Board-Outline/Macro_Keyboard_V1.0/Macro_Keyboard_Main_Board_V1.0/Battery Notes.txt

Considered chargers - BQ25170, BQ24075RGT

https://tinycircuits.com/collections/batteries

https://tpetrov.com/baterii/akumulatorni-baterii/li-po-baterii

https://vikiwat.com/akumulatorni-baterii.html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

https://www.olx.bg/d/ad/bateriya-3-7-v-180-mah-270-mah-7-4-v-2000mah-li-po-li-ion-battery-volta-CID632-ID7R0fO.html
