Board-Outline/Macro_Keyboard_V1.0/(threads)

Thread 1 (2023-06-14):

Questions regarding setup

WainingForests, 2023-06-14:
The MDBT50Q-1MV2; how does one go about programming flashing? Is it simple SMD solder all the required components and then flash it with ZMK firmware? Or do I need to figure out how to flash it with nordic SDK / use the hex from the Mikoto repo?

Any clarity on this would be greatly appreciated!

Board-Outline, 2023-06-28:
Hi.

I apologize for the lack of instructions in this project. I believed this repo was set to private. I was going to open source it after I completed it.

First you need to install a nRF52 bootloader from [here](https://github.com/adafruit/Adafruit_nRF52_Bootloader). Then you can install ZMK as normal. Keep in mind that I still don't have a correct configuration written, I took a long hiatus from this project), so you will have to write your own.

**Important note:** There are hardware problems with this board. the D+ and D- on the USB are flipped. There were also other problems with this board. Its a first prototype after all. I have notes written on my schematics at my home PC and I will commit them when I get back in a day or two. Read them carefully before you order this board.

Board-Outline, 2023-06-28:
The module works well with ZMK and I had some configuration written for it. By memory I don't think I had huge software problems. The only problem I had was with soldering, since its an LGA. It took me a 2-3 tries with a hot plate to solder it properly.
In case you are going to reuse the battery schematic, keep in mind that I've only done very limited testing with the battery. No long term safety testing at all.

I've attached a photo of the board with all the problems I've found:
- Flipped USB Lines
- Wrong power on the SWD connector (the cut and the wire are for that)
- Wrong footprint on Q1 (Source and drain are switched)
- Wrong footprint on TH1

I've really screwed the pooch on such a simple board, but the MCU boots and it works.

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

WainingForests, 2023-06-28:
I'm taking the new mikoto battery circuitry and using it based on your work. My biggest concern was me not understanding how bootloaders were programed but with the pico probe I've managed to at least get the mikoto bootloader working. Next up is figuring how to modify the bootloader settings which is very much out of my wheel house.

I swear getting a prototype without 3 bodge wires for me is like hitting the lottery!

Board-Outline, 2023-06-28:
I've never used the Pico Probe, It looks to be a nice bit of kit. A personal favorite debugger/programmer is the Segger J-Link EDU. Its slightly more expensive but the Segger software is so good compared to OpenOCD. The important thing is that you've done that job and you made it work. :)

At work I tend to design more complex projects (300-500 components on a board) and usually I have lower error rate on first prototypes. It was my second time using KiCAD and most of my attention was focused on using it correctly. Still its bodgable, and it works fine.

Best of luck on your project, if you need any help, feel free to ask.
