Board-Outline/Macro_Keyboard_V1.0/Macro_Keyboard_Main_Board_V1.0/Macro_Keyboard_Main_Board_V1.0.kicad_pcb

## KiCad design Macro_Keyboard_Main_Board_V1.0/Macro_Keyboard_Main_Board_V1.0.kicad_pcb (2022-11-27)

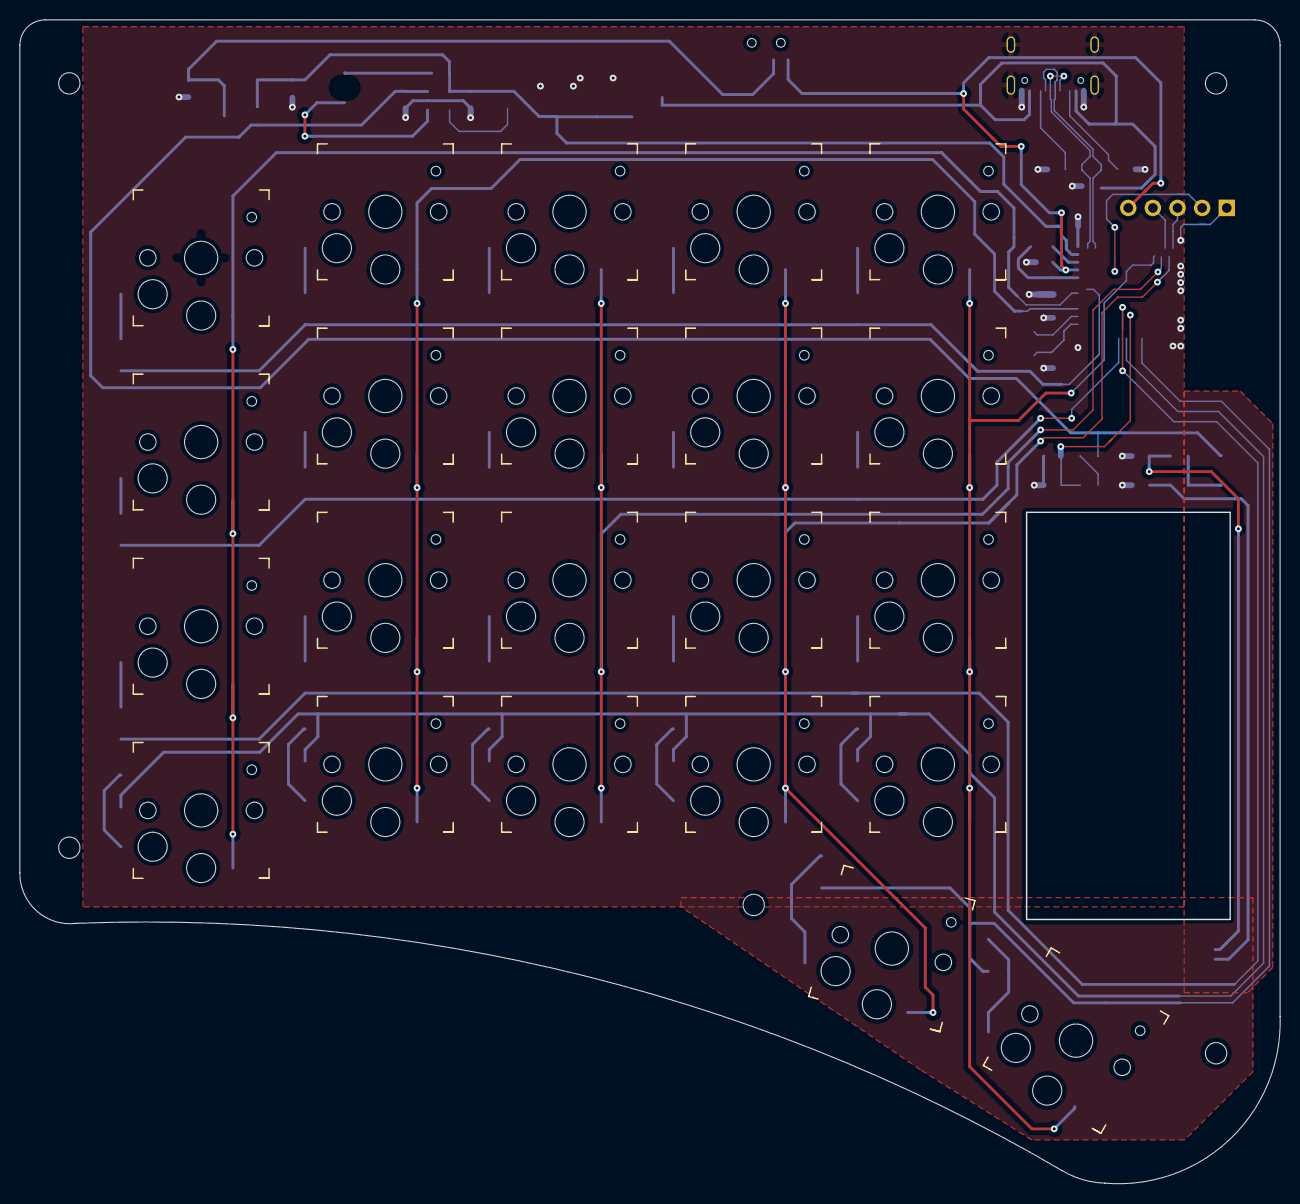
[picture p20: board Macro_Keyboard_Main_Board_V1.0.kicad_pcb from above]

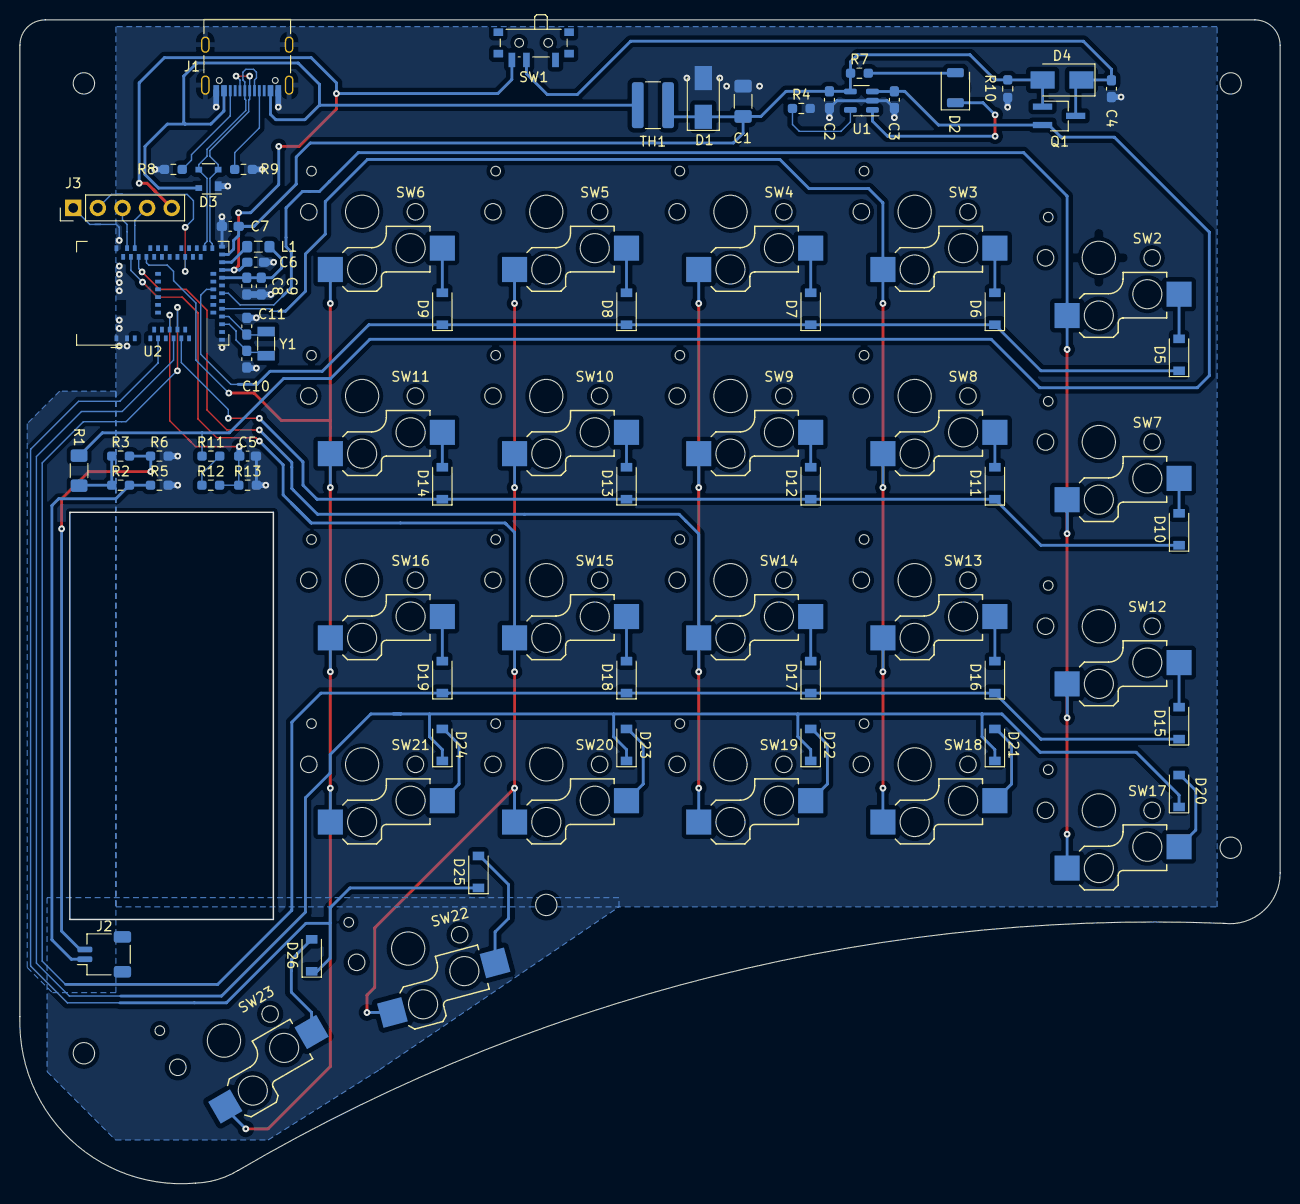
[picture p21: board Macro_Keyboard_Main_Board_V1.0.kicad_pcb from below]

Board: 2 copper layers, 130.0 x 120.1 mm, 87 parts (60 on the bottom side), 57 nets.

Parts:
C1: 10uF; C_1206_3216Metric_Pad1.33x1.80mm_HandSolder
C2, C3, C4, C6, C7, C9: 4u7F; C_0603_1608Metric_Pad1.08x0.95mm_HandSolder
C5: 10nF; C_0603_1608Metric_Pad1.08x0.95mm_HandSolder
C8: 1uF; C_0603_1608Metric_Pad1.08x0.95mm_HandSolder
C10, C11: 15pF; C_0603_1608Metric_Pad1.08x0.95mm_HandSolder
D1: SMAJ5.0A; D_SMA
D2: LED; LED_1206_3216Metric_ReverseMount_Hole1.8x2.4mm
D3: PRTR5V0U2X; SOT-143
D4: B160-E3; D_SMA
D5, D6, D7, D8, D9, D10, D11, D12, D13, D14, D15, D16, D17, D18, D19, D20, D21, D22, D23, D24, D25, D26: 1N4148W; D_SOD-123
H1, H2, H3, H4, H5: MountingHole M2; MountingHole_2.2mm_M2_ISO14580
J1: USB_C_Receptacle_USB2.0; USB_C_Receptacle_Palconn_UTC16-G
J2: JST SM02B-SRSS-TB(LF)(SN); JST_SH_SM02B-SRSS-TB_1x02-1MP_P1.00mm_Horizontal
J3: Conn_01x05; PinHeader_1x05_P2.54mm_Vertical
L1: 10uH; L_0805_2012Metric_Pad1.05x1.20mm_HandSolder
Q1: DMG2301L-7; TSOT-23_HandSoldering
R1: 0R; R_1206_3216Metric_Pad1.30x1.75mm_HandSolder
R2, R6, R7: N.F.; R_0603_1608Metric_Pad0.98x0.95mm_HandSolder
R3, R5: 0R; R_0603_1608Metric_Pad0.98x0.95mm_HandSolder
R4: 20K; R_0603_1608Metric_Pad0.98x0.95mm_HandSolder
R8, R9: 5K1; R_0603_1608Metric_Pad0.98x0.95mm_HandSolder
R10: 10K; R_0603_1608Metric_Pad0.98x0.95mm_HandSolder
R11, R12: 2M; R_0603_1608Metric_Pad0.98x0.95mm_HandSolder
R13: 10M; R_0603_1608Metric_Pad0.98x0.95mm_HandSolder
SW1: SW_SPDT PCM12SMTR; SW_SPDT_PCM12
SW2, SW3, SW4, SW5, SW6, SW7, SW8, SW9, SW10, SW11, SW12, SW13, SW14, SW15, SW16, SW17, SW18, SW19, SW20, SW21, SW22, SW23: SW_Push; Kailh_socket_PG1350
TH1: MF-MSMF050-2; R_1218_3246Metric_Pad1.22x4.75mm_HandSolder
U1: MCP73831T-2ACI/OT; SOT-23-5
U2: MDBT50Q-1MV2; Raytac_MDBT50Q
Y1: 32768Hz; Crystal_SMD_3215-2Pin_3.2x1.5mm

Connections:
+BATT: C3.1, Q1.2 (D), R1.1, R11.1, U1.3 (VBAT)
/keyboard/BAT_VOUT: C5.1, R12.2, R13.1, U2.9 (P0.03/AIN1)
/keyboard/CC1: J1.A5 (CC1), R9.1
/keyboard/CC2: J1.B5 (CC2), R8.1
/keyboard/COL1: SW2.1, SW7.1, SW12.1, SW17.1, U2.24 (P0.08)
/keyboard/COL2: SW3.1, SW8.1, SW13.1, SW18.1, U2.20 (P0.04/AIN2)
/keyboard/COL3: SW4.1, SW9.1, SW14.1, SW19.1, U2.50 (P1.02)
/keyboard/COL4: SW5.1, SW10.1, SW15.1, SW20.1, SW22.1, U2.52 (P0.09/NFC1)
/keyboard/COL5: SW6.1, SW11.1, SW16.1, SW21.1, SW23.1, U2.49 (P0.25)
/keyboard/RESET: J3.2, U2.40 (~RESET/P0.18)
/keyboard/ROW1: D5.1 (K), D6.1 (K), D7.1 (K), D8.1 (K), D9.1 (K), U2.25 (P1.08)
/keyboard/ROW2: D10.1 (K), D11.1 (K), D12.1 (K), D13.1 (K), D14.1 (K), U2.12 (P0.31/AIN7)
/keyboard/ROW3: D15.1 (K), D16.1 (K), D17.1 (K), D18.1 (K), D19.1 (K), U2.11 (P0.02/AIN0)
/keyboard/ROW4: D20.1 (K), D21.1 (K), D22.1 (K), D23.1 (K), D24.1 (K), U2.10 (P0.29/AIN5)
/keyboard/ROW5: D25.1 (K), D26.1 (K), U2.6 (P1.13)
/keyboard/SWDCLK: J3.3, U2.53 (SWDCLK)
/keyboard/SWDIO: J3.4, U2.51 (SWDIO)
/keyboard/USB_N: D3.3 (I/O2), J1.A7 (D-), J1.B7 (D-), U2.35 (D+)
/keyboard/USB_P: D3.2 (I/O1), J1.A6 (D+), J1.B6 (D+), U2.34 (D-)
GND: C1.2, C2.2, C3.2, C4.2, C5.2, C6.2, C7.2, C8.2, C9.2, C10.1, C11.1, D1.2 (A), D3.1 (GND), J1.A1 (GND), J1.A12 (GND), J1.B1 (GND), J1.B12 (GND), J1.S1 (SHIELD), J3.1, R4.2, R5.2, R6.2, R8.2, R9.2, R10.2, R13.2, U1.2 (VSS), U2.1 (GND), U2.2 (GND), U2.15 (GND), U2.33 (GND), U2.55 (GND)
unnamed: C4.1, D4.1 (K), Q1.3 (S), SW1.2 (B)
unnamed: C8.1, C9.1, L1.1, U2.28 (VDD)
unnamed: C10.2, U2.17 (XL1/P0.00), Y1.1
unnamed: C11.2, U2.18 (XL2/P0.01), Y1.2
unnamed: D2.1 (K), U1.1 (STAT)
unnamed: D2.2 (A), R7.2
unnamed: D3.4 (VCC), J1.A4 (VBUS), J1.A9 (VBUS), J1.B4 (VBUS), J1.B9 (VBUS), TH1.2
unnamed: D5.2 (A), SW2.2
unnamed: D6.2 (A), SW3.2
unnamed: D7.2 (A), SW4.2
unnamed: D8.2 (A), SW5.2
unnamed: D9.2 (A), SW6.2
unnamed: D10.2 (A), SW7.2
unnamed: D11.2 (A), SW8.2
unnamed: D12.2 (A), SW9.2
unnamed: D13.2 (A), SW10.2
unnamed: D14.2 (A), SW11.2
unnamed: D15.2 (A), SW12.2
unnamed: D16.2 (A), SW13.2
unnamed: D17.2 (A), SW14.2
unnamed: D18.2 (A), SW15.2
unnamed: D19.2 (A), SW16.2
unnamed: D20.2 (A), SW17.2
unnamed: D21.2 (A), SW18.2
unnamed: D22.2 (A), SW19.2
unnamed: D23.2 (A), SW20.2
unnamed: D24.2 (A), SW21.2
unnamed: D25.2 (A), SW22.2
unnamed: D26.2 (A), SW23.2
unnamed: J2.1, R2.2, R5.1
unnamed: J2.2, R3.2, R6.1
unnamed: L1.2, U2.31 (DCCH)
unnamed: R1.2, R2.1, R3.1
unnamed: R4.1, U1.5 (PROG)
unnamed: R11.2, R12.1
VBUS: C1.1, C2.1, C7.1, D1.1 (K), D4.2 (A), Q1.1 (G), R7.1, R10.1, TH1.1, U1.4 (VDD), U2.32 (VBUS)
VDD: C6.1, J3.5, SW1.3 (C), U2.30 (VDDH)
