Board-Outline/Macro_Keyboard_V1.0/(commit log)

2022-11-24 Initial Comit
    [Keyboard.kicad_sch, Macro_Keyboard_Main_Board_V1.0.kicad_pcb, Macro_Keyboard_Main_Board_V1.0.kicad_sch]
2022-11-27 Weekend changes
    [Macro_Keyboard_Main_Board_V1.0.kicad_pcb]
2022-12-05 Newest Changes Added
    [Keyboard.kicad_sch, Macro_Keyboard_Bottom_V1.0.kicad_pcb]
2023-09-09 Added notes
    [Keyboard.kicad_sch, Macro_Keyboard_Main_Board_V1.0.kicad_sch]
