Board-Outline/Macro_Keyboard_V1.0/(notices)

Notices in the files:
Macro_Keyboard_Main_Board_V1.0/keyswitches.pretty-master/keyswitches.pretty-master/README.md:
CC BY-SA 4.0
